kaidev04/Quadruped-Robot-Arduino/README.md

# Quadruped-Robot-Arduino
This was a high school project with the intention of developing a quadruped robot or robot dog. In this repository you can find the Arduino code that was used for the robot dog. The code is not as polished as it could be due to deadlines and its main purpose was only for testing, not production. But it is functional for the prototype that I made using 12 servo motors and an IMU sensor. It was my first attempt at robotics and I have plans to improve upon this model and its code in the future.

The thesis for the project, written in Swedish, can be read in the PDF file provided.
